BasicCode/function-generator-arduino/images/1mhz-fft.png

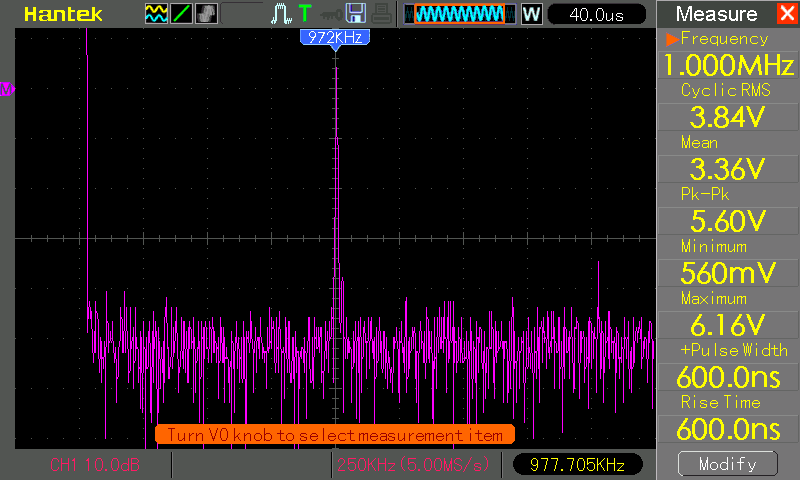
images/1mhz-fft.png
