BasicCode/function-generator-arduino/images/10mhz-fft.png

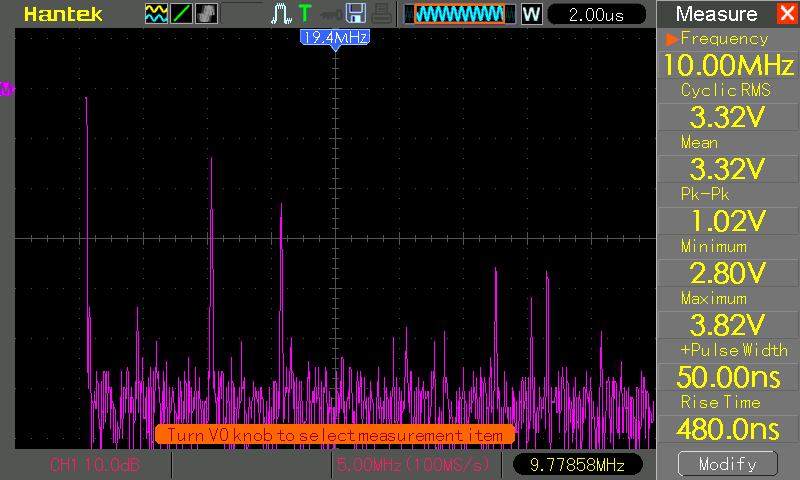
images/10mhz-fft.png
